pamconti/datalogger-epta/firmware/Core/Inc/main.h

#define LED_STATUS_Pin GPIO_PIN_13
#define LED_STATUS_GPIO_Port GPIOC
#define BTN_USER_Pin GPIO_PIN_0
#define BTN_USER_GPIO_Port GPIOA
#define IMU_CS_Pin GPIO_PIN_2
#define IMU_CS_GPIO_Port GPIOA
#define IMU_CSA4_Pin GPIO_PIN_4
#define IMU_CSA4_GPIO_Port GPIOA
#define IMU_INT1_Pin GPIO_PIN_0
#define IMU_INT1_GPIO_Port GPIOB
#define IMU_INT1_EXTI_IRQn EXTI0_IRQn
#define SD_DETECT_Pin GPIO_PIN_1
#define SD_DETECT_GPIO_Port GPIOB
