pamconti/datalogger-epta/(commit log)

2026-10-21 Configuração inicial do CubeMX: pinagem, clock, FatFs e RTC
    - Pinagem do STM32F411CEU6 definida no CubeMX (SDIO 4 bits, SPI1, I2C1, USB, USART2, SWD, GPIOs)
    - Clock em 96 MHz a partir do HSE de 25 MHz, com 48 MHz para USB e SDIO
    - RTC no LSE, TIM2 como base de tempo de 1 us, FatFs sobre SDIO com DMA
    - Projeto gerado para o STM32CubeIDE, compilando sem erros e sem warnings
    - README e registro de decisões de projeto
    - .gitignore para saídas de compilação e arquivos locais
2026-10-22 Esquemático revisado
    - Correção do pull-down do BOOT0
    - Filtro do VDDA com ferrite
    - Footprint de 4 pads no cristal de 25 MHz
    - Regras de projeto e classe de rede Power
    [datalogger.kicad_sch]
